Rangel-the-Ranch/Arcade-game-v2/documentation/presentationArcade.pdf

# Аркада

Рангел Плачков 1MI0800061
2 курс КН 6 група

# Задание

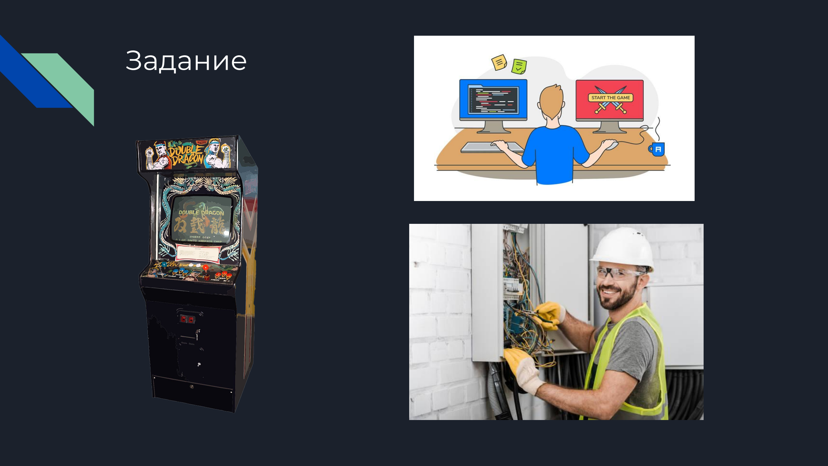
[picture p3: page 2]

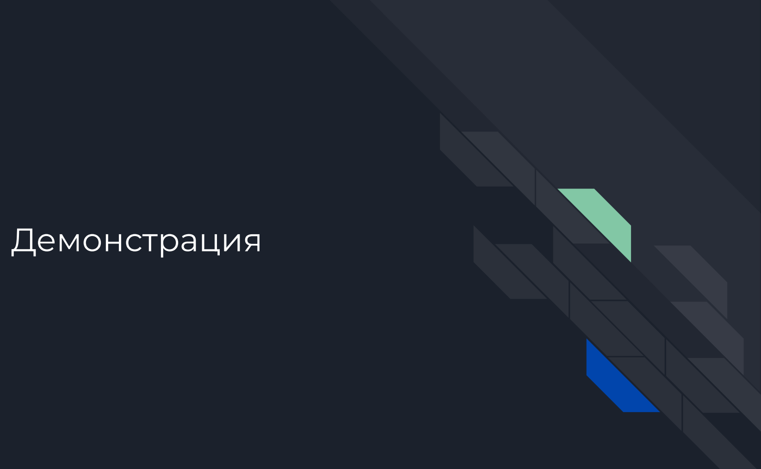
[picture p4: figure]
Демонстрация

# Лесно писане на игри от програмисти

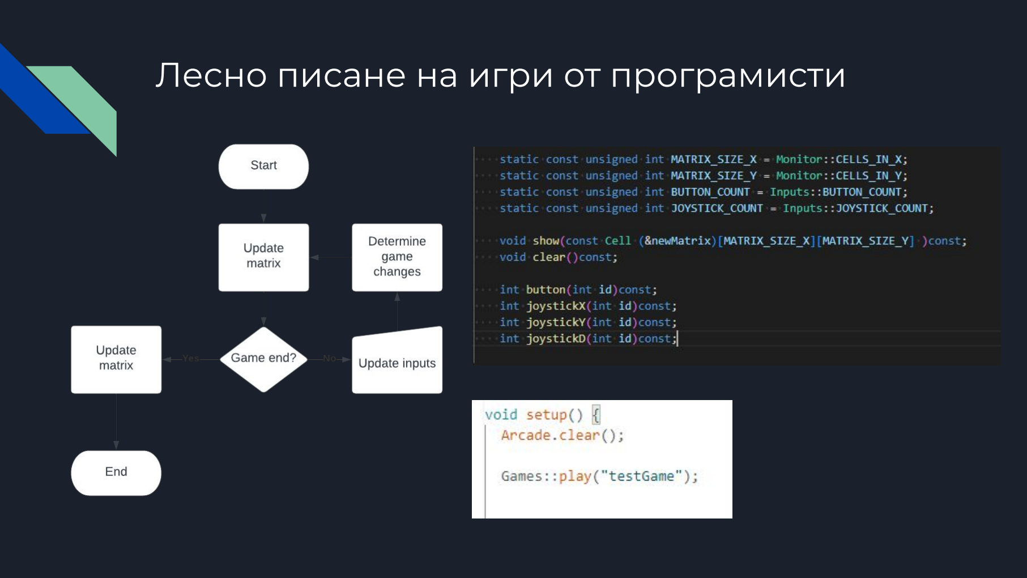
[picture p5: page 4]

# Бюджет и електронни компоненти

Електронни компоненти: 210лв.

3д филамент : 60лв.

Изгорели електронни компоненти: 60лв.

Общо 330лв.

Ел. Компоненти

Arduino mega 2560 PRO L

6бр. WS 2812 LED-Matrix 16x16

5бр. Бутони

2бр. Joystick Dual axis XY module

Захранващ блок 220AC -> 12DC

2бр. Конвертор на напрежение 12DC -> 5DC

Други ( джъмпери, болтове ,гайки, тенол, … )

# Разработка и проблеми

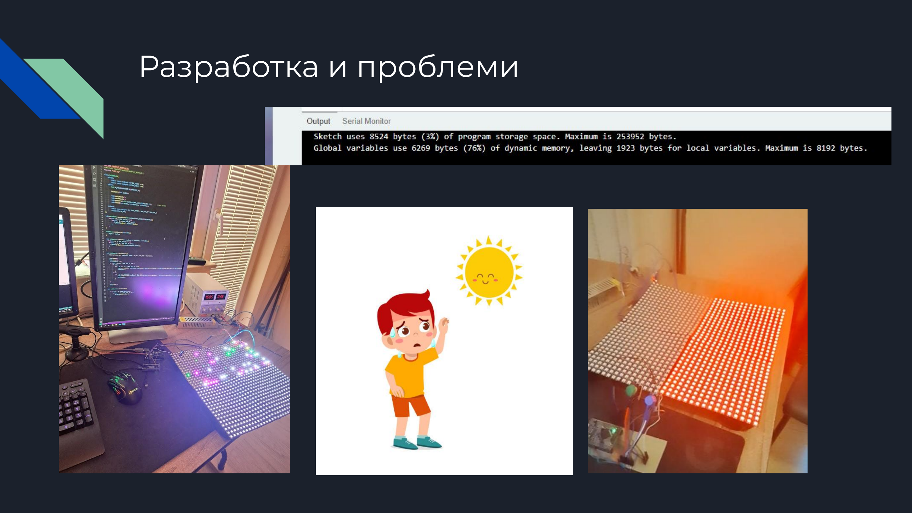
[picture p6: page 6]
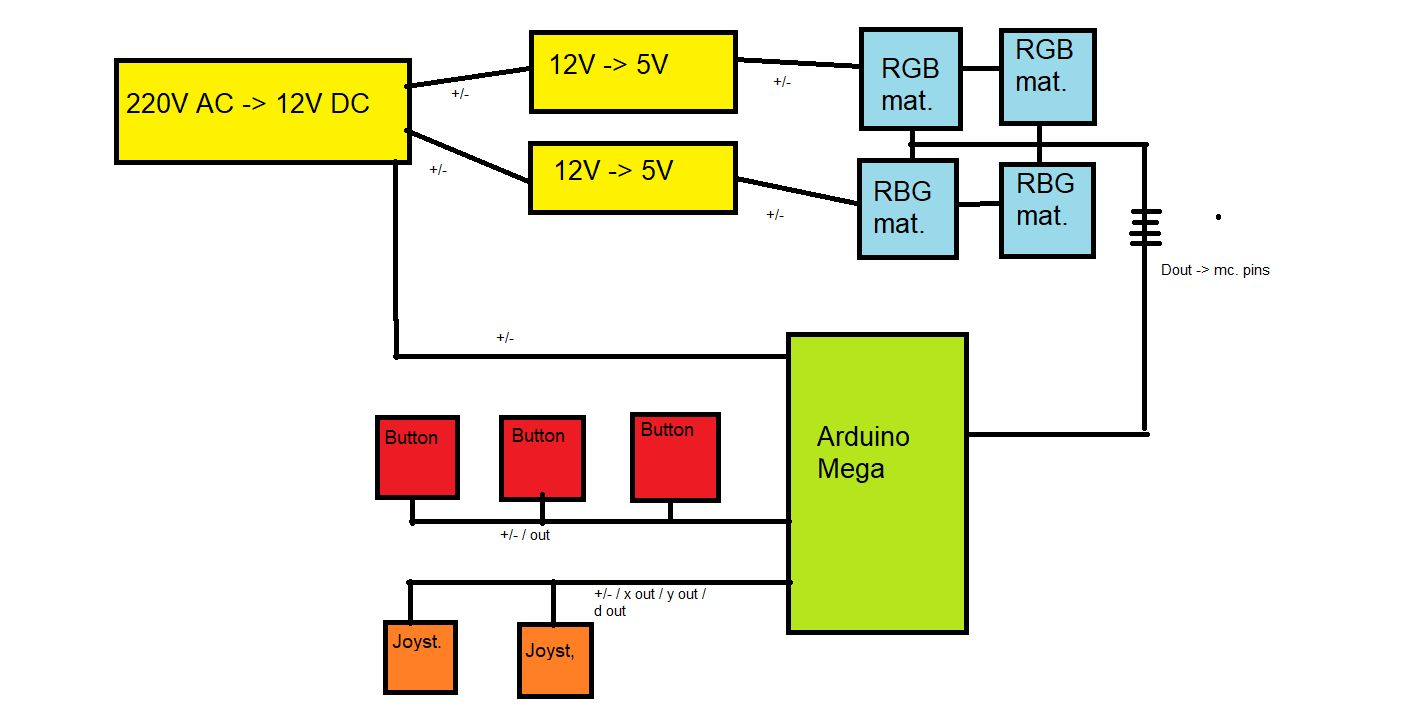
[picture p7: page 7]
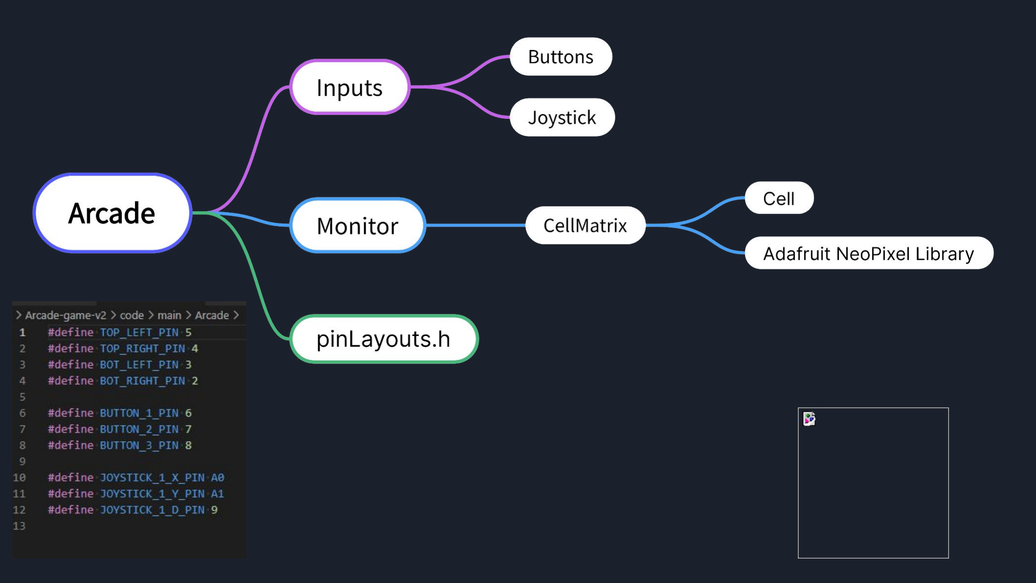
[picture p8: page 8]

# Идеи за подобрение

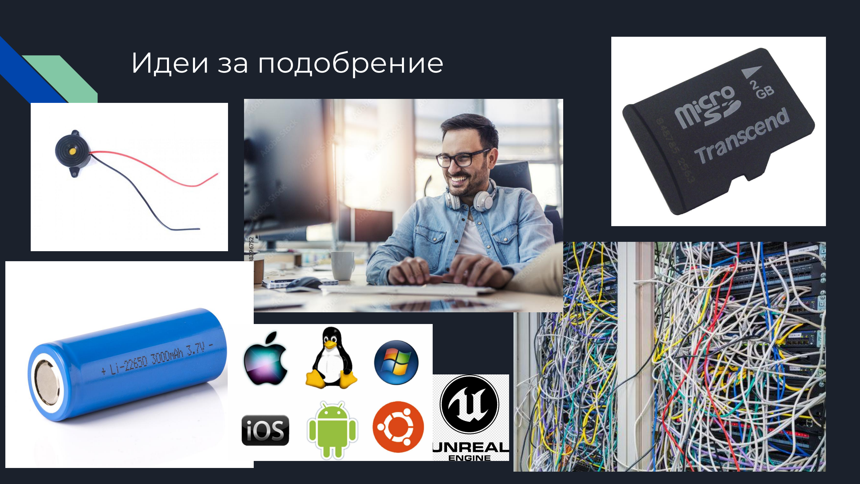
[picture p9: page 9]

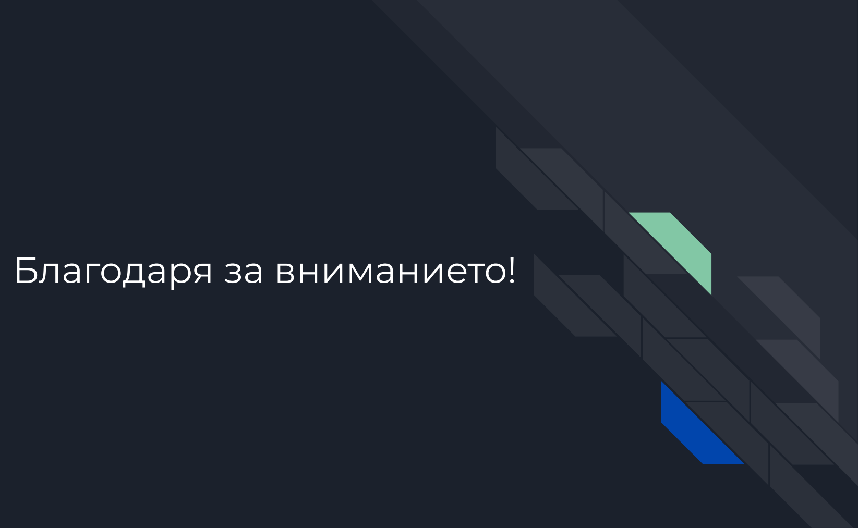
[picture p10: figure]
Благодаря за вниманието!
