Rangel-the-Ranch/Arcade-game-v2/documentation/presentationPics/360_F_242039807_7qgvG1oLQMGCUYN2ADTTRV80tDP3bAyZ.jpg

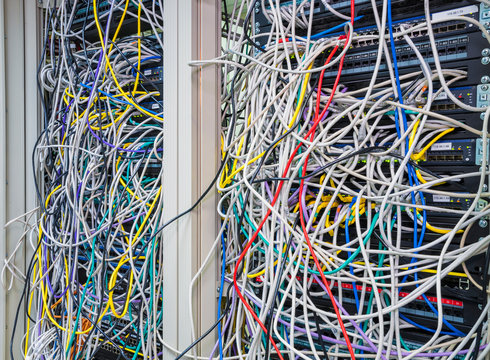
documentation/presentationPics/360_F_242039807_7qgvG1oLQMGCUYN2ADTTRV80tDP3bAyZ.jpg
