Rangel-the-Ranch/Arcade-game-v2/documentation/presentationPics/1000_F_198396752_XxqNXmAo9Cg7Hiw8qHp8V3i0JezJwSEK.jpg

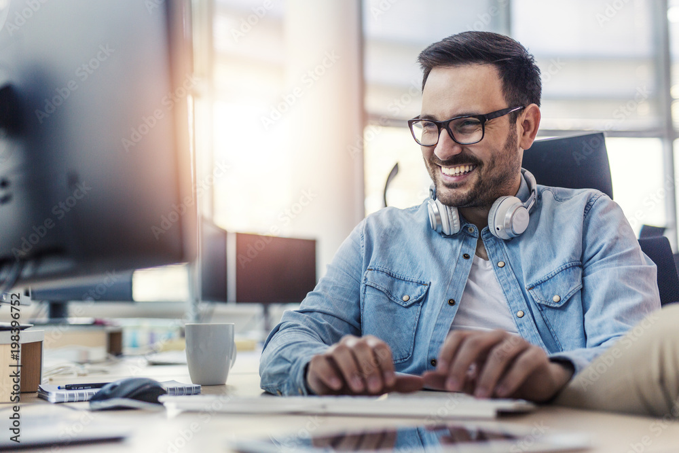
documentation/presentationPics/1000_F_198396752_XxqNXmAo9Cg7Hiw8qHp8V3i0JezJwSEK.jpg
