Rangel-the-Ranch/Arcade-game-v2/documentation/presentationPics/2290242-40.jpg

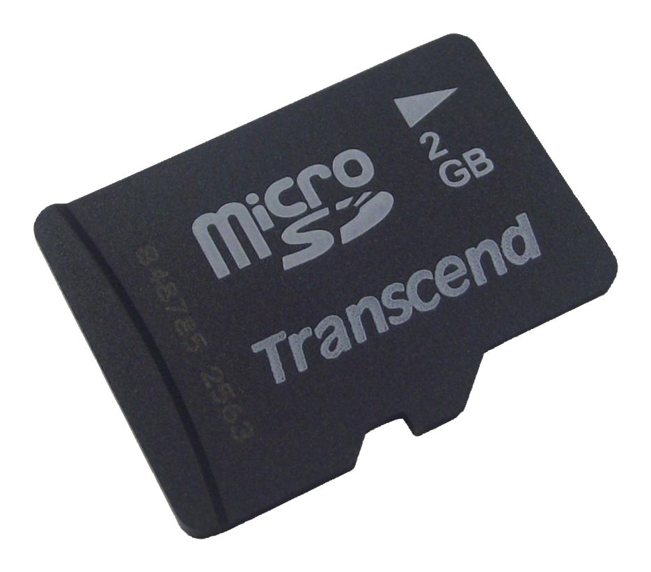
documentation/presentationPics/2290242-40.jpg
