Rangel-the-Ranch/Arcade-game-v2/documentation/presentationPics/20230116_104547.jpg

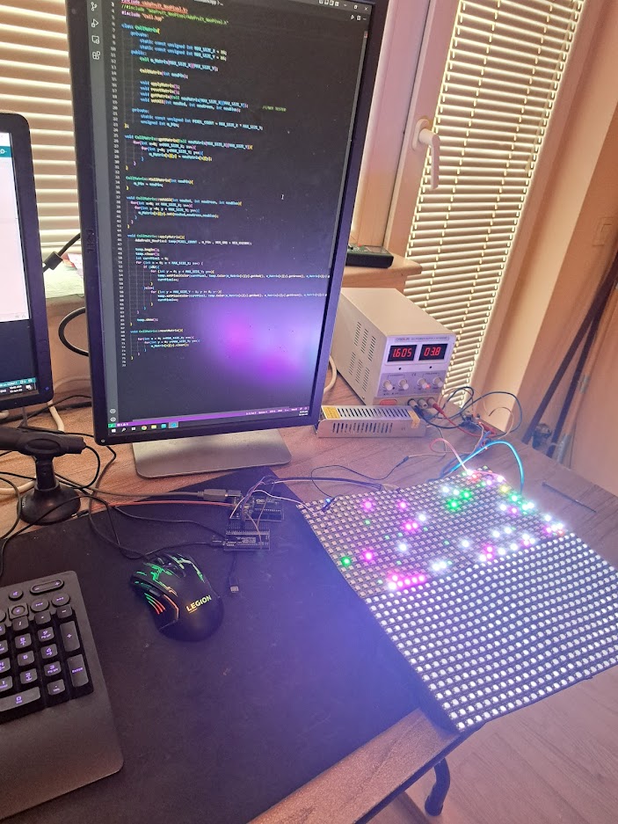
documentation/presentationPics/20230116_104547.jpg
