Rangel-the-Ranch/Arcade-game-v2/documentation/presentationPics/Arcade-Machine-Transparent-Background.png

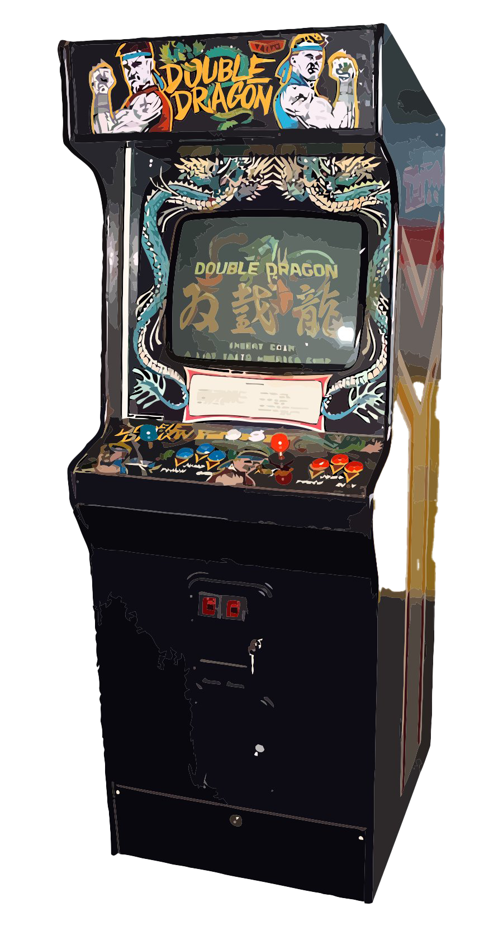
documentation/presentationPics/Arcade-Machine-Transparent-Background.png
