Rangel-the-Ranch/Arcade-game-v2/documentation/presentationPics/GameDeveloper-1024x910.webp

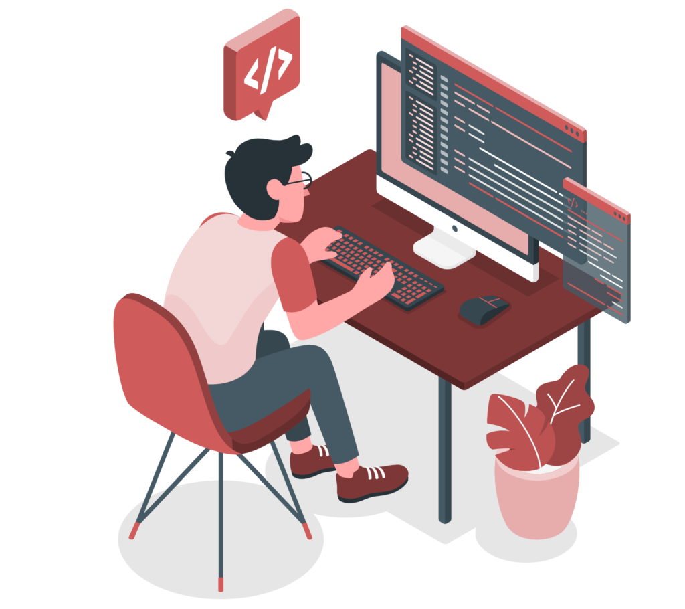
documentation/presentationPics/GameDeveloper-1024x910.webp
