Rangel-the-Ranch/Arcade-game-v2/documentation/presentationPics/istockphoto-1286311969-612x612.jpg

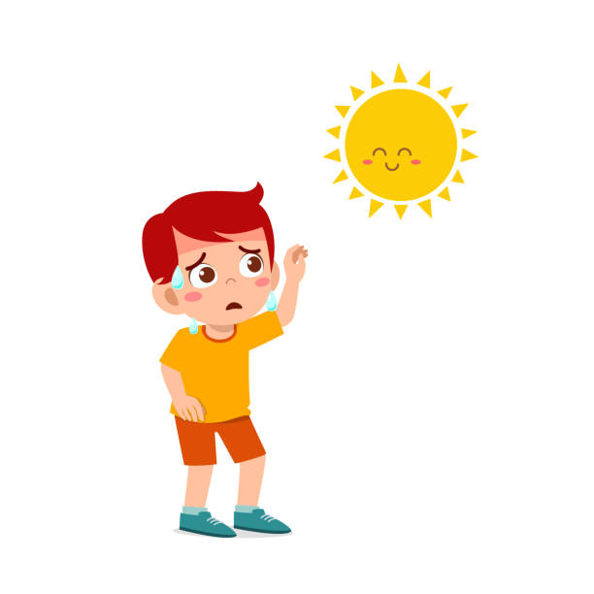
documentation/presentationPics/istockphoto-1286311969-612x612.jpg
