Rangel-the-Ranch/Arcade-game-v2/documentation/presentationPics/piezo-buzzer-3-to-24v-hp2312xw-2124-970x728.jpg

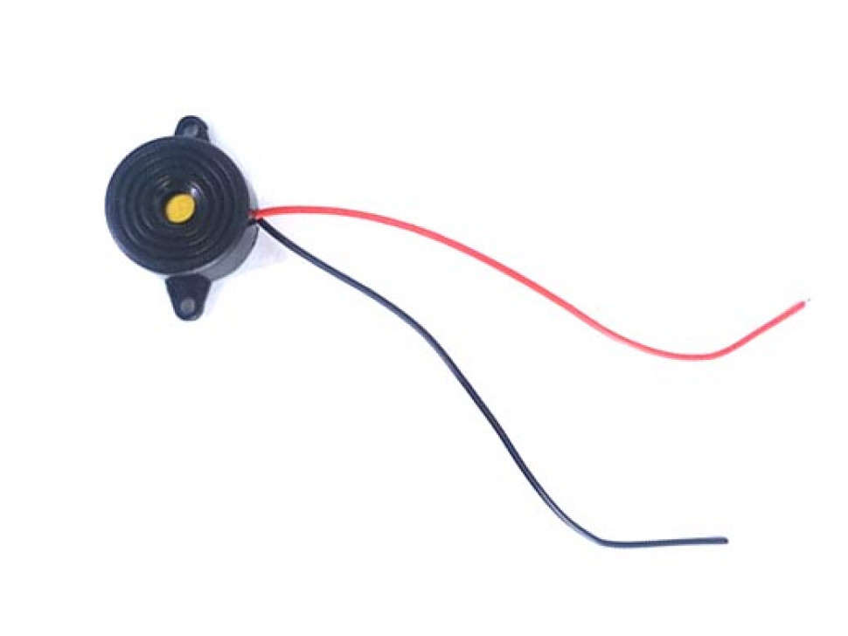
documentation/presentationPics/piezo-buzzer-3-to-24v-hp2312xw-2124-970x728.jpg
