Rangel-the-Ranch/Arcade-game-v2/documentation/presentationPics/Screenshot_1.png

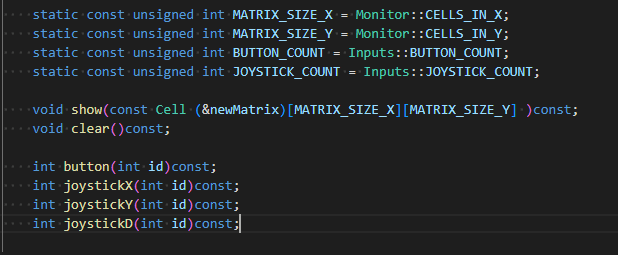
documentation/presentationPics/Screenshot_1.png
