Rangel-the-Ranch/Arcade-game-v2/documentation/presentationPics/Screenshot_2.png

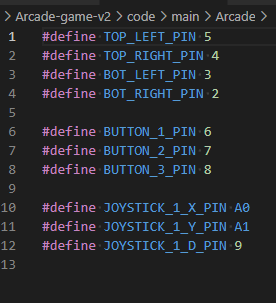
documentation/presentationPics/Screenshot_2.png
