Rangel-the-Ranch/Arcade-game-v2/documentation/progres videos/halfWorking.png

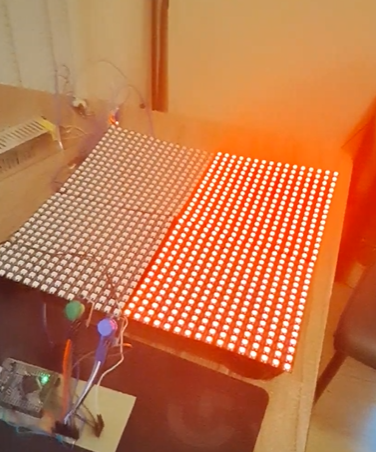
documentation/progres videos/halfWorking.png
